mwojt3/445-Team-70/README.md

# 445-Team-70
Markdown lab notebook for team 70's project: automatic drum tuner
