mwojt3/445-Team-70/models/README.md

A place to put any models we make, 3d models for a housing, etc
