mwojt3/445-Team-70/pcb files/README.md

this is where we shall place all of our printed circuit pcb board files
