mwojt3/445-Team-70/models/PCB Housing 445 v3.stl

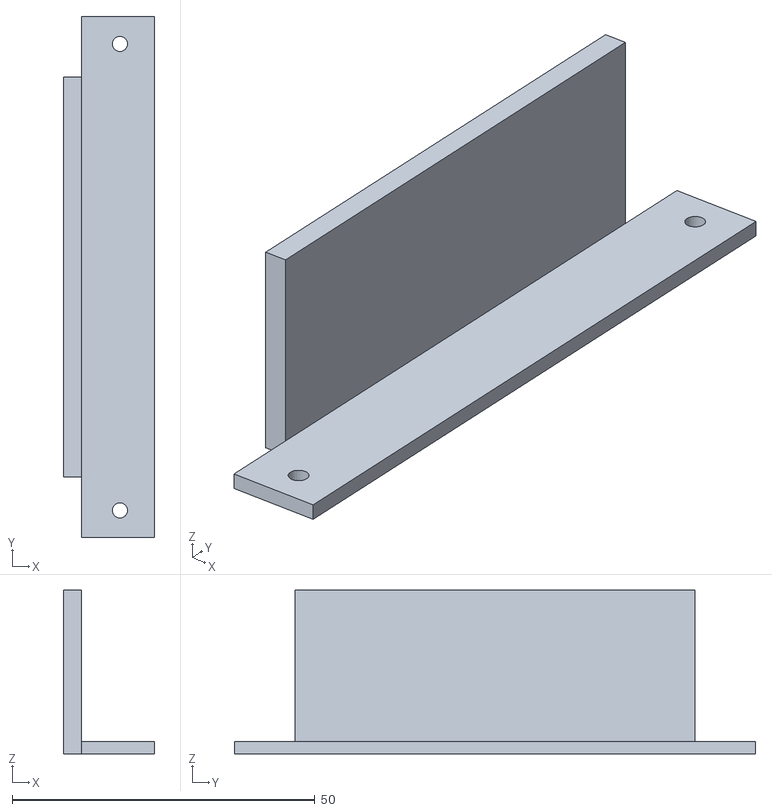
[picture p1: CAD file, 2025-05-08]
models/PCB Housing 445 v3.stl
15.0 x 86.0 x 27.0
