mwojt3/445-Team-70/models/Housing Final.stl

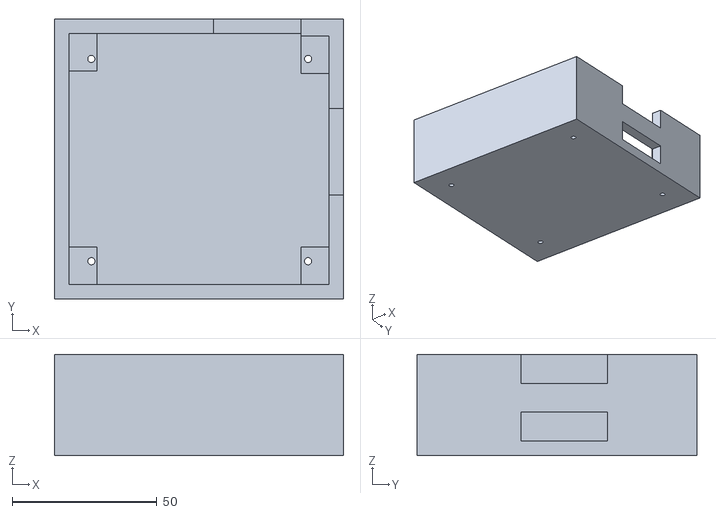
[picture p2: CAD file, 2025-05-08]
models/Housing Final.stl
100.0 x 97.0 x 35.0
