mwojt3/445-Team-70/models/battery_case.stl

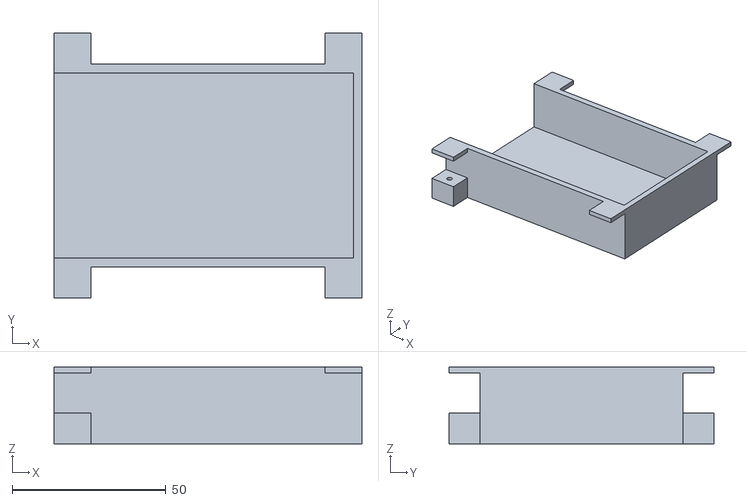
[picture p3: CAD file, 2025-05-08]
models/battery_case.stl
100.0 x 86.0 x 25.0
