mwojt3/445-Team-70/models/actuator_slab.3mf

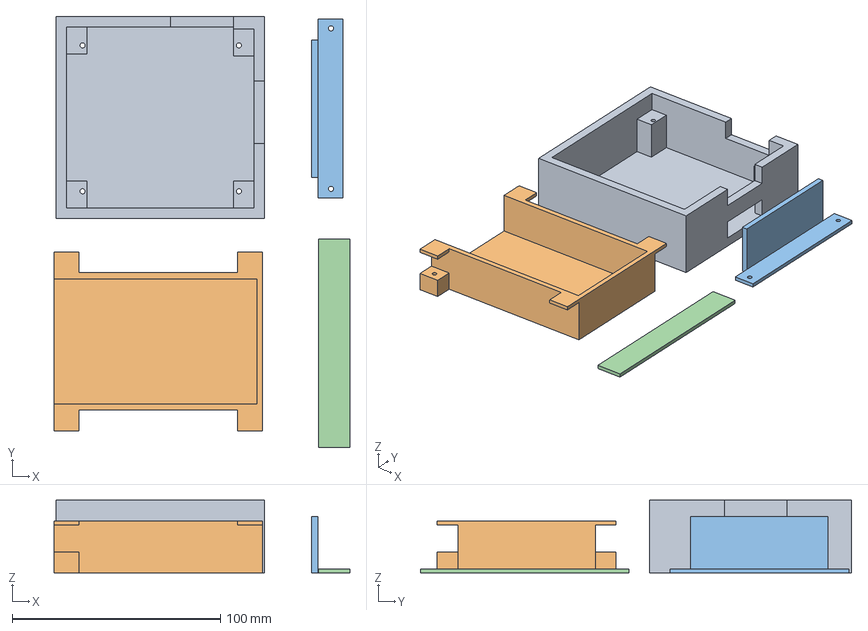
[picture p4: CAD file, 2025-05-08]
models/actuator_slab.3mf
141.8 x 206.8 x 35.0 mm
Housing Final.stl
battery_case.stl
PCB Housing 445 v3.stl
actuator_slab.stl
