mwojt3/445-Team-70/models/445 Cover.3mf

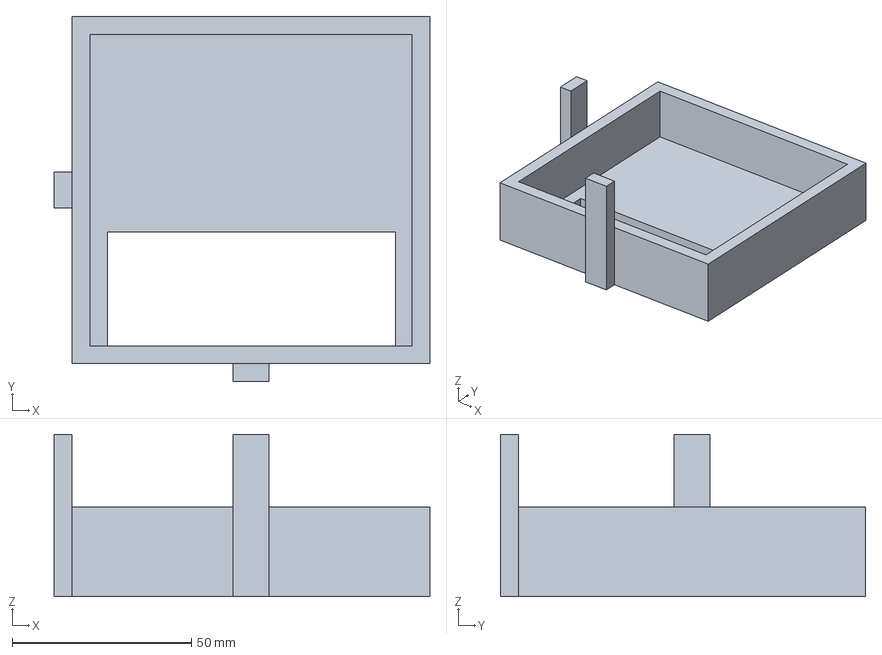
[picture p5: CAD file, 2025-05-08]
models/445 Cover.3mf
105.0 x 102.0 x 45.3 mm
