mwojt3/445-Team-70/models/servo adapter.stl

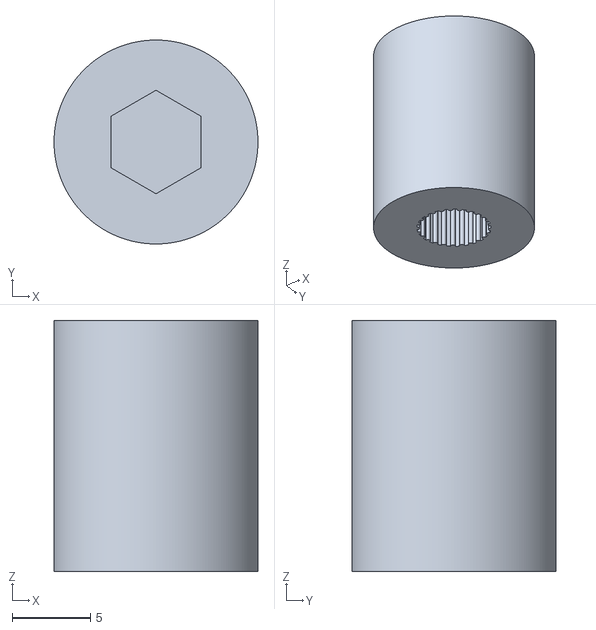
[picture p6: CAD file, 2025-05-08]
models/servo adapter.stl
13.0 x 13.0 x 16.0
