mwojt3/445-Team-70/(list of files, cad)

Other CAD files:
models/445 Cover.stl
models/actuator_slab.stl
