mwojt3/445-Team-70/notebooks/max/entries/February 20, 2025.pdf

2 20 2025

## objectives figureoutforce from servo toadapteroutput

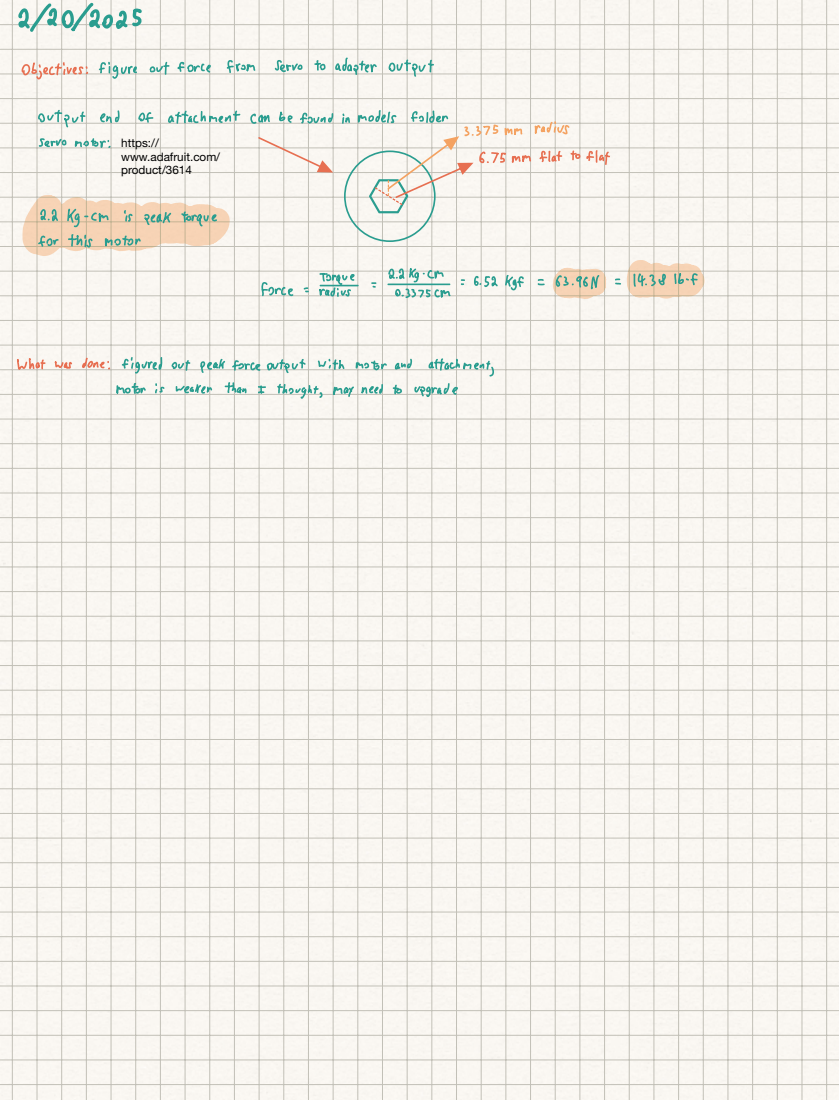
[picture p7: page 1]
output end; attachmentcanbefoundinmodels folder; servomotor; Isinfi toHa; 22kgcm ispeaktorque forthismotor; force; 6.52Kgf; whatwasdone; figuredoutpeakforceoutputwithmotorand attachment; motorisweakerthan; I thought mayneedto upgrade

https://
www.adafruit.com/
product/3614
