mwojt3/445-Team-70/notebooks/max/entries/March 13, 2025.pdf

3 13 2025

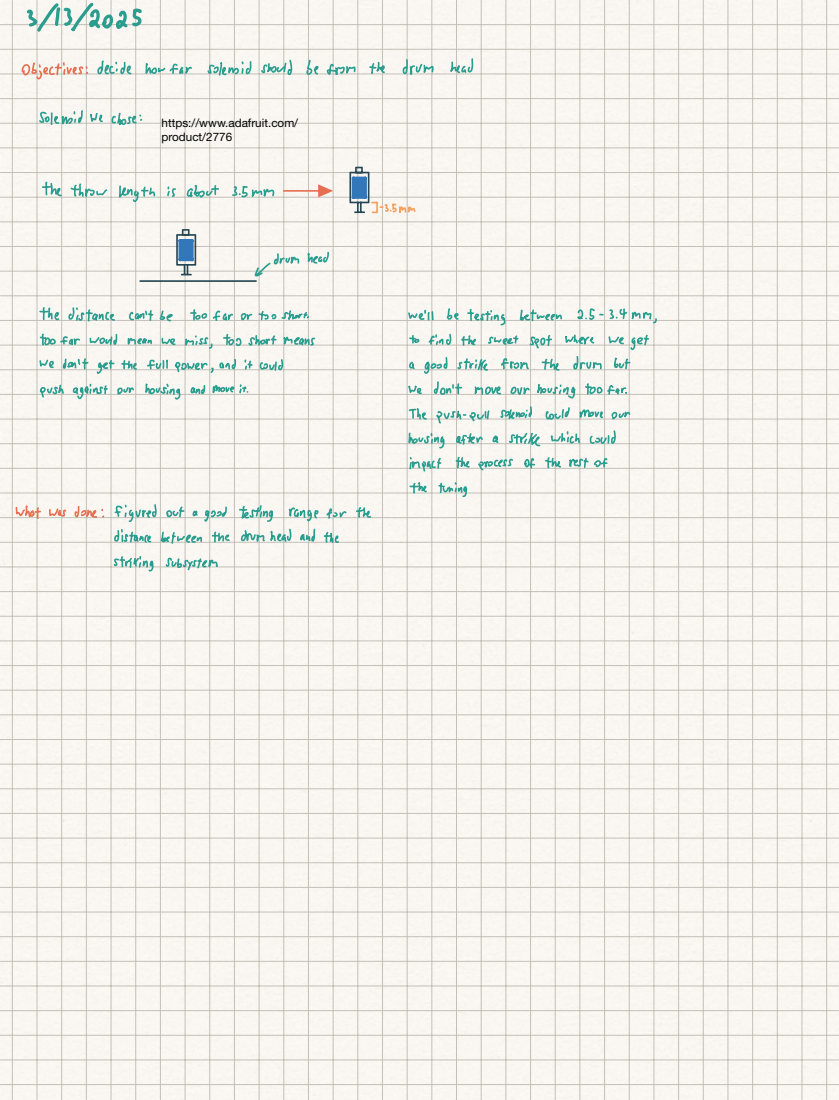
[picture p8: page 1]
Solenoidwechose; thethrowlength isabout3.5mm; drumhead; thedistance can'tbe toofar ortooshort; we'llbetesting between 2.5 3.4mm; toofar wouldmeanwemiss tooshortmeans; tofindthesweetspot where; weget; wedon'tgetthefullpoweranditcould; agoodstrikefromthedrumbut; pushagainstour housingandmoveit; wedon'tmoveourhousingtoofar; Thepushpullsolenoid couldmoveour housingaftera strikewhichcould impact theprocessoftherestof; thetuning; whatwasdone figuredoutagoodtesting; rangeforthe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

objectives decidehowfar solenoidshouldbefromthe drum head

https://www.adafruit.com/
product/2776
