mwojt3/445-Team-70/pcb files/Second Round PCB/Second Round PCB/First Round PCB.pdf

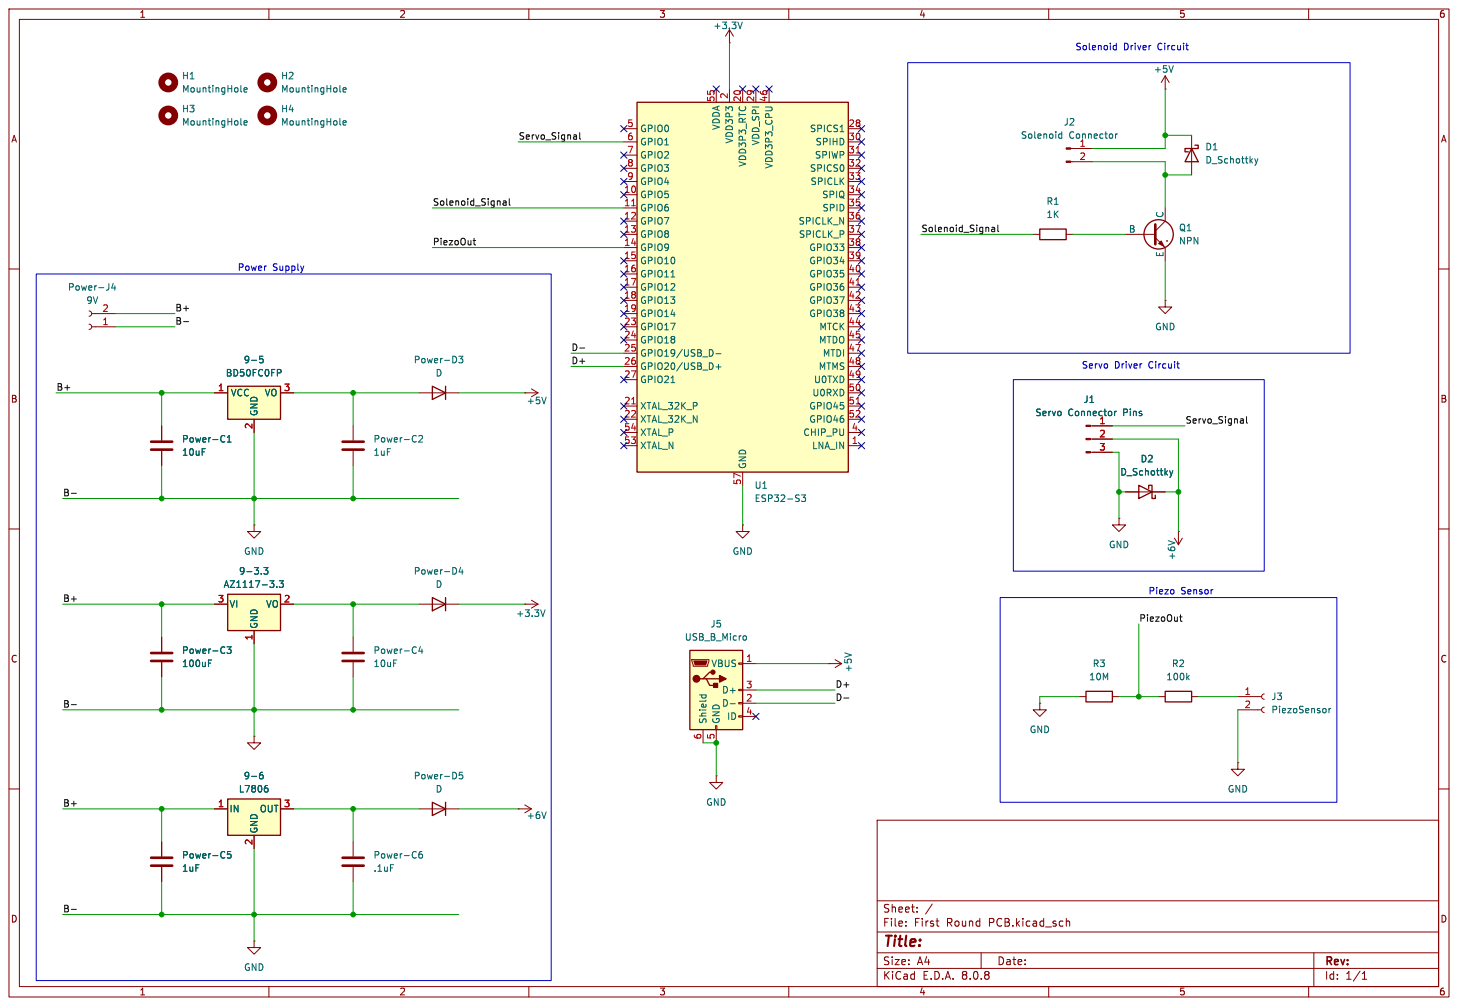
[picture p9: page 1]

2 VDD3P3_RTC 20 XTAL_32K_P 21 XTAL_32K_N 22 GPIO17 23 GPIO18 24 GPIO19/USB_D- 25 GPIO20/USB_D+ 26 GPIO21 27 SPICS1 28 VDD_SPI 29 SPIHD 30 SPIWP 31 SPICS0 32 SPICLK 33 SPIQ 34 SPID 35 SPICLK_P 37 GPIO33 38 GPIO34 39 CHIP_PU 4 GPIO35 40 GPIO36 41 GPIO37 42 GPIO38 43 MTCK 44 VDD3P3_CPU 46 MTDI 47 MTMS 48 U0TXD 49 GPIO0 5 U0RXD 50 GPIO46 52 XTAL_N 53 XTAL_P 54 VDDA 55 GND 57 GPIO1 6 GPIO2 7 GPIO3 8 GPIO4 9 U1ESP32-S3 GND GND
