mwojt3/445-Team-70/notebooks/max/entries/March 3, 2025.pdf

3 5 2025

In

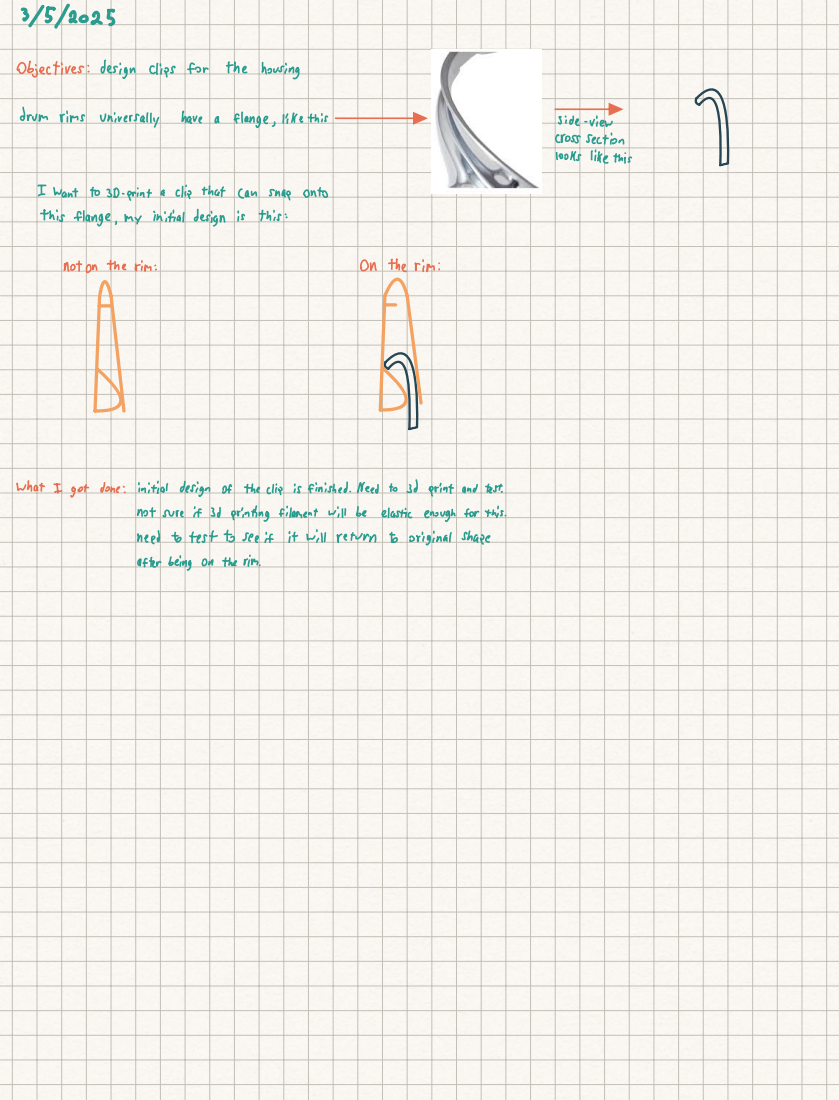
[picture p10: page 1]
Objectives; designclips for the housing; notontherim; ontherim; what I gotdone initialdesignoftheclipisfinishedNeedto3dprintandtest; notsureif3dprintingfilamentwillbe elasticenoughforthis; needtotesttoseeif; itwillreturntooriginalshare; afterbeingontherim

drumrims universally have a flange likethis

Iwantto3Dprintaclipthatcansnaponto
thisflange myinitialdesign is this
