mwojt3/445-Team-70/pcb files/Second Round PCB/Second Round PCB/First Round PCB.kicad_pcb

## KiCad design pcb files/Second Round PCB/Second Round PCB/First Round PCB.kicad_pcb (2025-04-14)

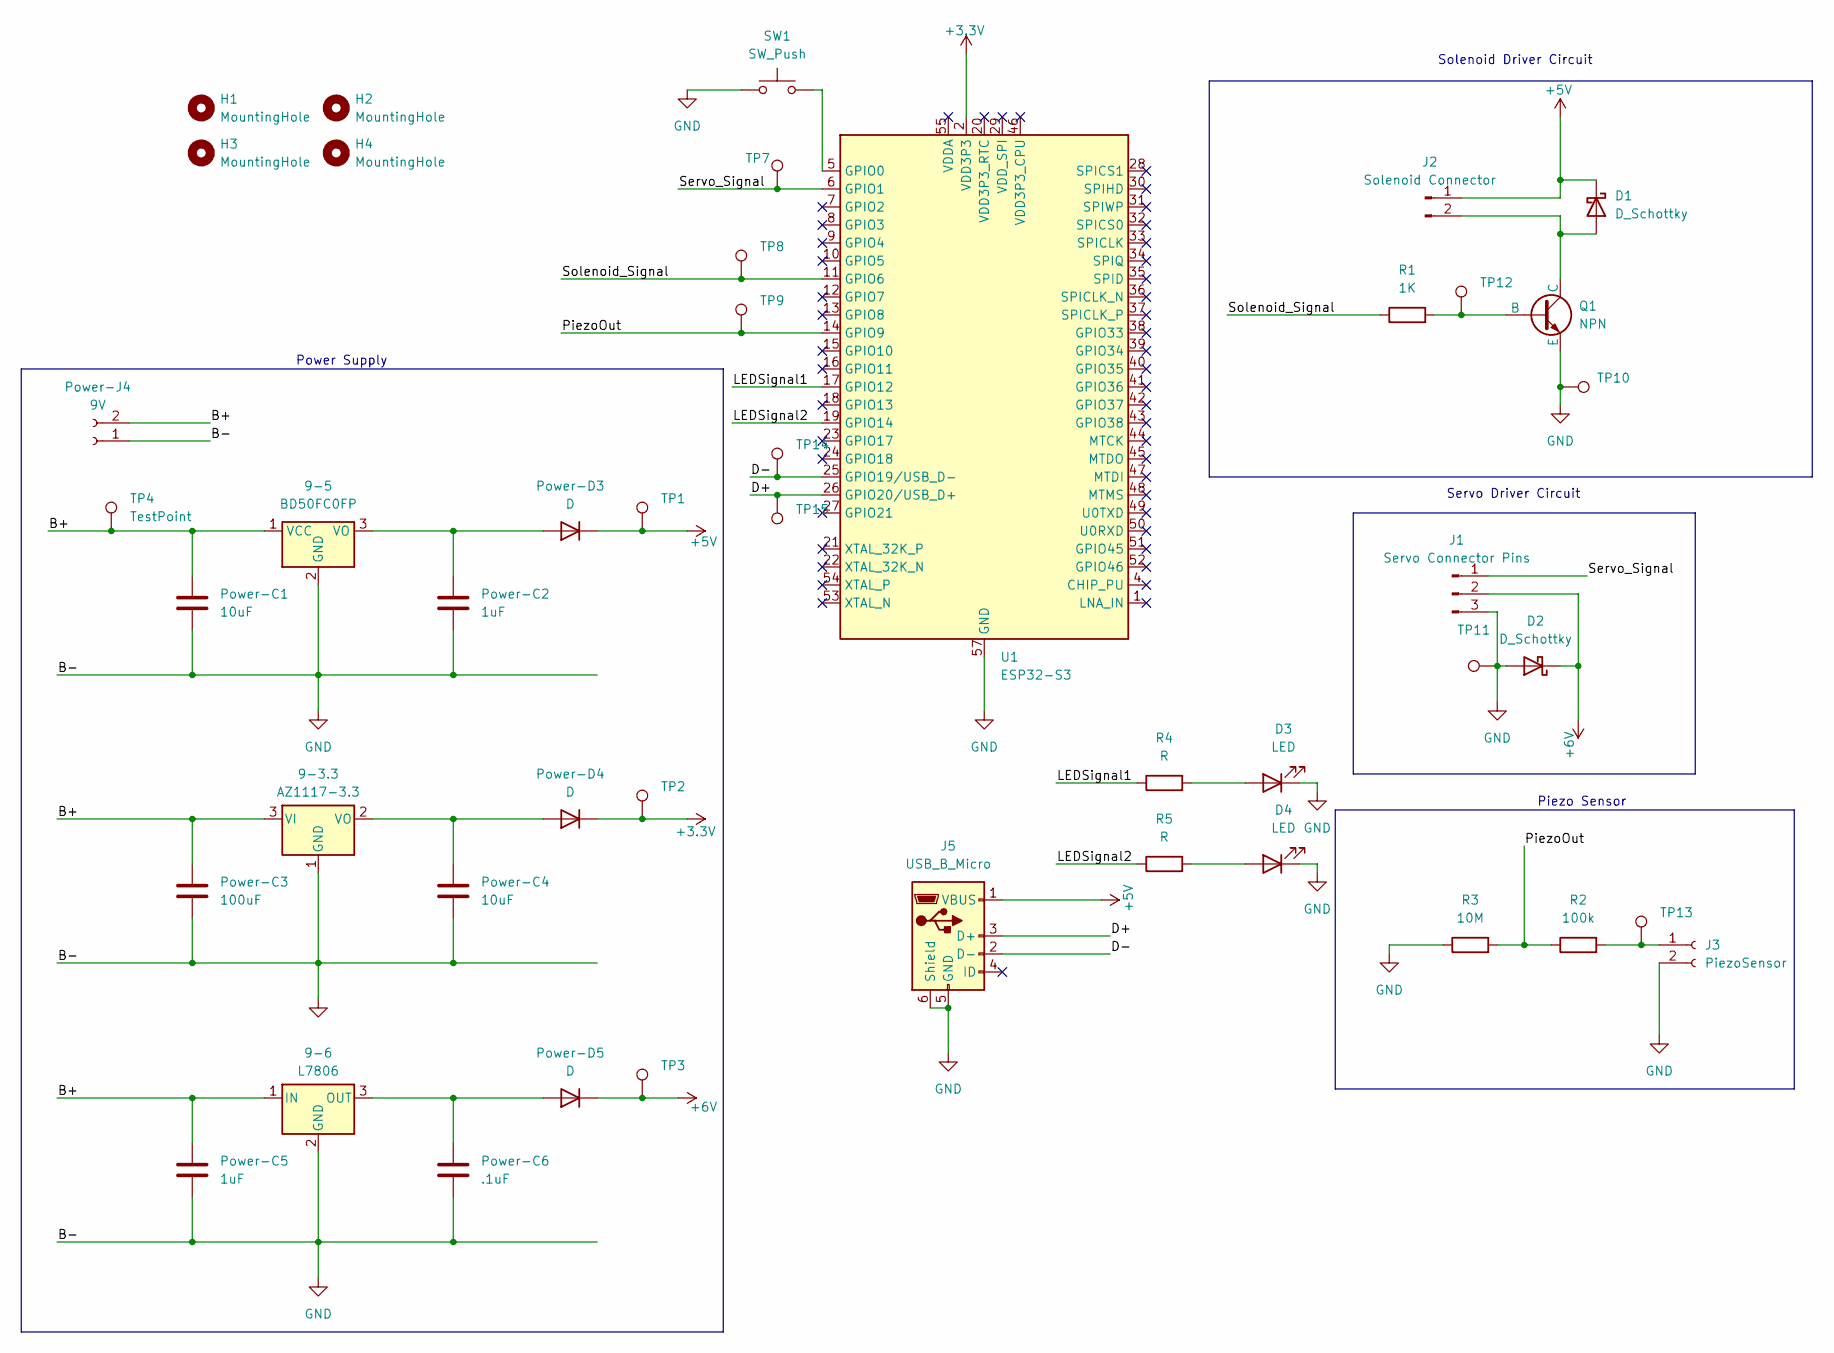
[picture p11: schematic First Round PCB.kicad_sch]

Parts:
9-3.3: AZ1117-3.3; TO-252-3_TabPin2
9-5: BD50FC0FP; TO-252-2
9-6: L7806; TO-263-3_TabPin2
D1, D2: D_Schottky; D_SMA-SMB_Universal_Handsoldering
D3, D4: LED; LED_D3.0mm
H1, H2, H3, H4: MountingHole; MountingHole_3.2mm_M3
J1: Servo Connector Pins; Molex_KK-254_AE-6410-03A_1x03_P2.54mm_Vertical
J2: Solenoid Connector; Molex_KK-254_AE-6410-02A_1x02_P2.54mm_Vertical
J3: PiezoSensor; Molex_KK-254_AE-6410-02A_1x02_P2.54mm_Vertical
J5: USB_B_Micro; USB_Micro-B_Amphenol_10118194-0001LF_Horizontal
Power-C1, Power-C4: 10uF; C_0805_2012Metric_Pad1.18x1.45mm_HandSolder
Power-C2, Power-C5: 1uF; C_0805_2012Metric_Pad1.18x1.45mm_HandSolder
Power-C3: 100uF; C_0805_2012Metric_Pad1.18x1.45mm_HandSolder
Power-C6: .1uF; C_0805_2012Metric_Pad1.18x1.45mm_HandSolder
Power-D3, Power-D4, Power-D5: D; D_SMA-SMB_Universal_Handsoldering
Power-J4: 9V; Molex_KK-254_AE-6410-02A_1x02_P2.54mm_Vertical
Q1: NPN; TO-262-3_Vertical
R1: 1K; R_0805_2012Metric_Pad1.20x1.40mm_HandSolder
R2: 100k; R_0805_2012Metric_Pad1.20x1.40mm_HandSolder
R3: 10M; R_0805_2012Metric_Pad1.20x1.40mm_HandSolder
R4, R5: R; R_0805_2012Metric_Pad1.20x1.40mm_HandSolder
SW1: SW_Push; SW_SPST_PTS647_Sx38
TP1, TP2, TP3, TP4, TP7, TP8, TP9, TP10, TP11, TP12, TP13, TP14, TP15: TestPoint; TestPoint_Pad_D2.0mm
U1: ESP32-S3; QFN-56-1EP_7x7mm_P0.4mm_EP4x4mm

Connections:
+3.3V: Power-D4.1 (K), TP2.1, U1.2 (VDD3P3), U1.3 (VDD3P3)
+5V: D1.1 (K), J2.1, J5.1 (VBUS), Power-D3.1 (K), TP1.1
+6V: D2.1 (K), J1.2, Power-D5.1 (K), TP3.1
/B+: 9-3.3.3 (VI), 9-5.1 (VCC), 9-6.1 (IN), Power-C1.1, Power-C3.1, Power-C5.1, Power-J4.2, TP4.1; also elsewhere on the board
/D+: J5.3 (D+), TP15.1, U1.26 (GPIO20/USB_D+)
/D-: J5.2 (D-), TP14.1, U1.25 (GPIO19/USB_D-)
/LEDSignal1: R4.1, U1.17 (GPIO12)
/LEDSignal2: R5.1, U1.19 (GPIO14)
/PiezoOut: R2.1, R3.2, TP9.1, U1.14 (GPIO9)
/Servo_Signal: J1.1, TP7.1, U1.6 (GPIO1)
/Solenoid_Signal: R1.1, TP8.1, U1.11 (GPIO6)
GND: 9-3.3.1 (GND), 9-5.2 (GND), 9-6.2 (GND), D2.2 (A), D3.1 (K), D4.1 (K), J1.3, J3.2, J5.5 (GND), J5.6 (Shield), Power-C1.2, Power-C2.2, Power-C3.2, Power-C4.2, Power-C5.2, Power-C6.2, Power-J4.1, Q1.3 (E), R3.1, SW1.1, TP10.1, TP11.1, U1.57 (GND)
unnamed: 9-3.3.2 (VO), Power-C4.1, Power-D4.2 (A)
unnamed: 9-5.3 (VO), Power-C2.1, Power-D3.2 (A)
unnamed: 9-6.3 (OUT), Power-C6.1, Power-D5.2 (A)
unnamed: D1.2 (A), J2.2, Q1.1 (C)
unnamed: D3.2 (A), R4.2
unnamed: D4.2 (A), R5.2
unnamed: J3.1, R2.2, TP13.1
unnamed: Q1.2 (B), R1.2, TP12.1
unnamed: SW1.2, U1.5 (GPIO0)

Notes on the sheet:
Solenoid Driver Circuit
Power Supply
Servo Driver Circuit
Piezo Sensor

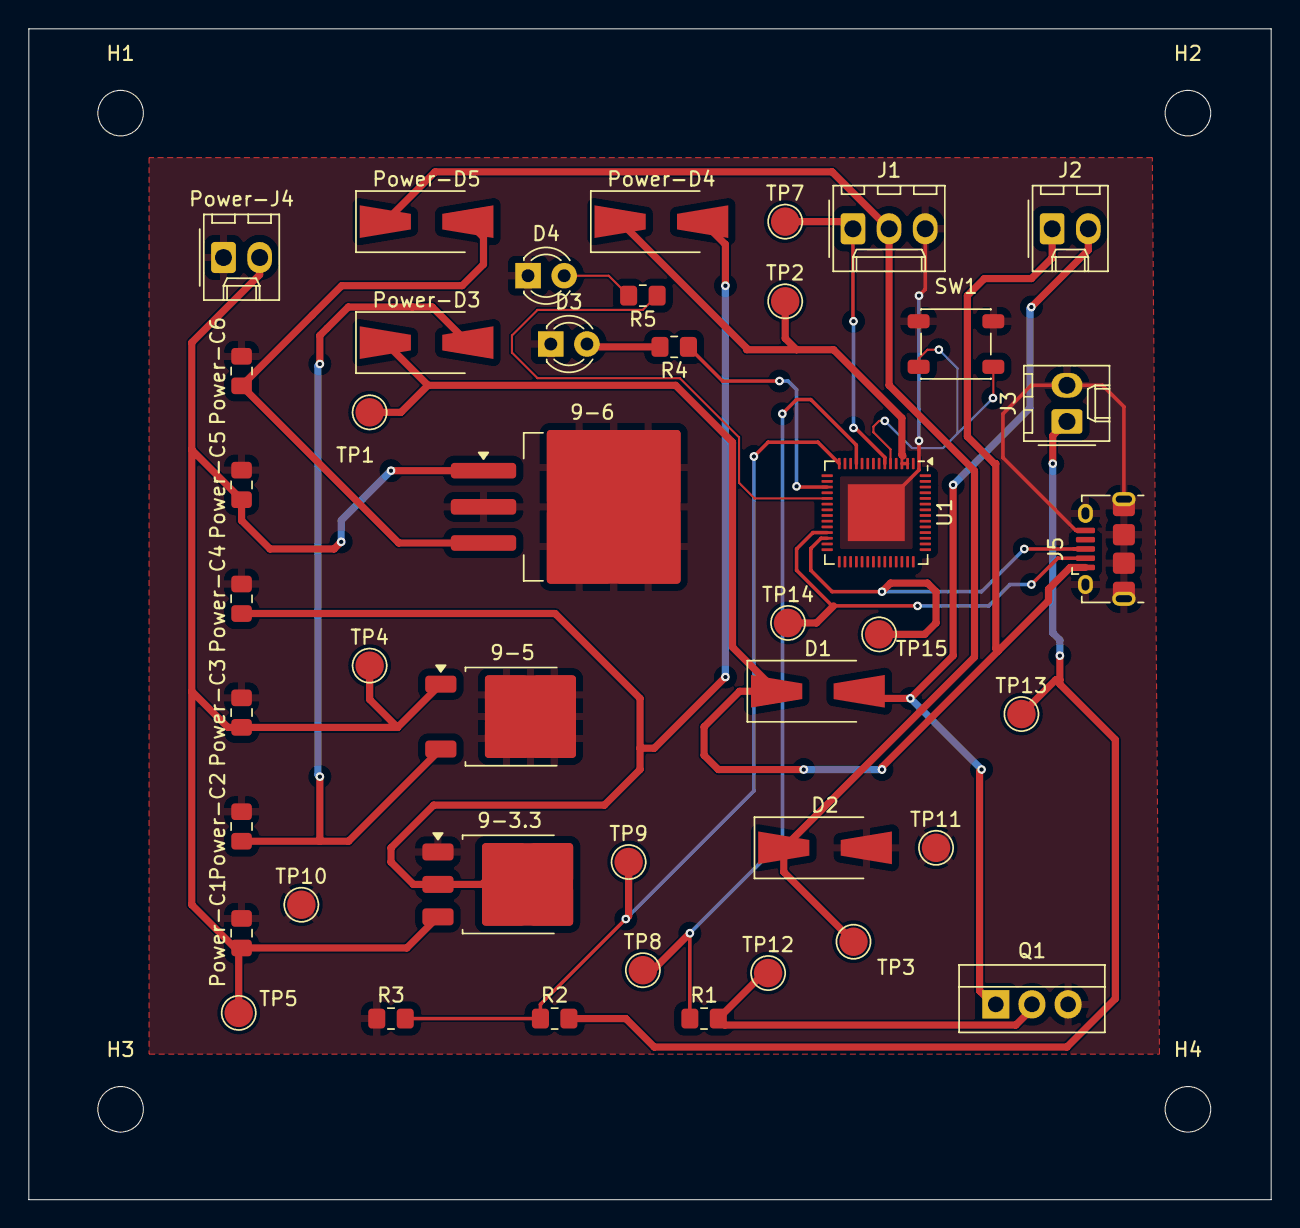
[picture p12: board First Round PCB.kicad_pcb from above]

Board: 2 copper layers, 87.3 x 82.3 mm, 47 parts (0 on the bottom side), 21 nets.

Other parts of the board:
TP5: TestPoint; TestPoint_Pad_D2.0mm

Their connections:
/B+: TP5.1; also elsewhere on the board
