mwojt3/445-Team-70/(commit log)

2025-02-14 Create README.md for pcb and folder for pcb files
2025-02-28 First Version of PCB
    [First Round PCB.kicad_pcb, First Round PCB.kicad_sch]
2025-02-28 First Round PCB
    [First Round PCB.kicad_pcb, First Round PCB.kicad_sch]
2025-05-08 Adding servo adapter CAD and stl files
    [servo adapter.scad, servo adapter.stl]
2025-05-08 Added STM prototype
2025-05-08 Microphone testing in ArduinoIDE
